kpierczy/zepic/readme.md

# Project description

This repository contains Altium-based design of the custom evaluation board for microcontrollers from Microchip based on the ZEPI project
from the AVT magazine.
