kpierczy/zepic/doc/datasheets/miscellanea/switch_4_7_botland.jpg

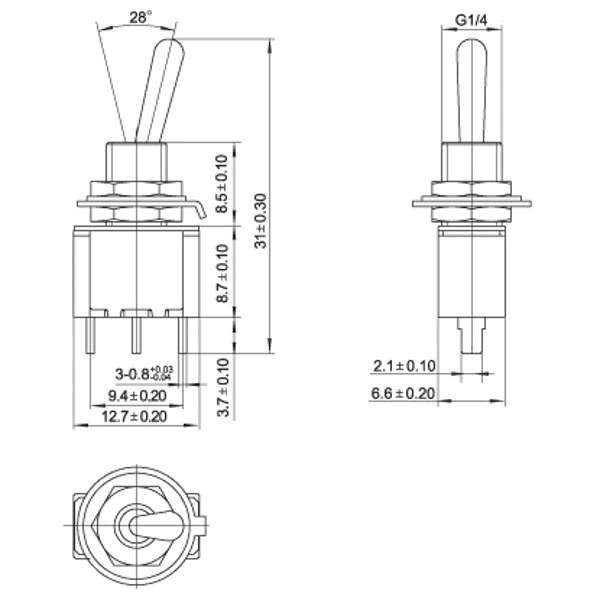
doc/datasheets/miscellanea/switch_4_7_botland.jpg
