kpierczy/zepic/(list of files, drawings)

Other design files:
arduino/ArduinoUnoSheild.PrjPcb
arduino/ArduinoUnoShield.PcbDoc
arduino/ArduinoUnoShield.SchDoc
arduino/Header.PcbLib
arduino/Header.SchLib
arduinoHeader.SchDoc
core.SchDoc
legacy/core.SchDoc
mainSheet.SchDoc
portsAndMemory.SchDoc
powerAndCommunication.SchDoc
sensorsAndExecutiveElements.SchDoc
userInterface.SchDoc
ZEPIC.PrjPcb
